JoseBarreto1/projeto-tcc-software/data/_initial.jpeg

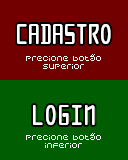
data/_initial.jpeg
