JoseBarreto1/projeto-tcc-software/data/_success.jpeg

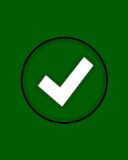
data/_success.jpeg
