JoseBarreto1/projeto-tcc-software/extra/mtmn.png

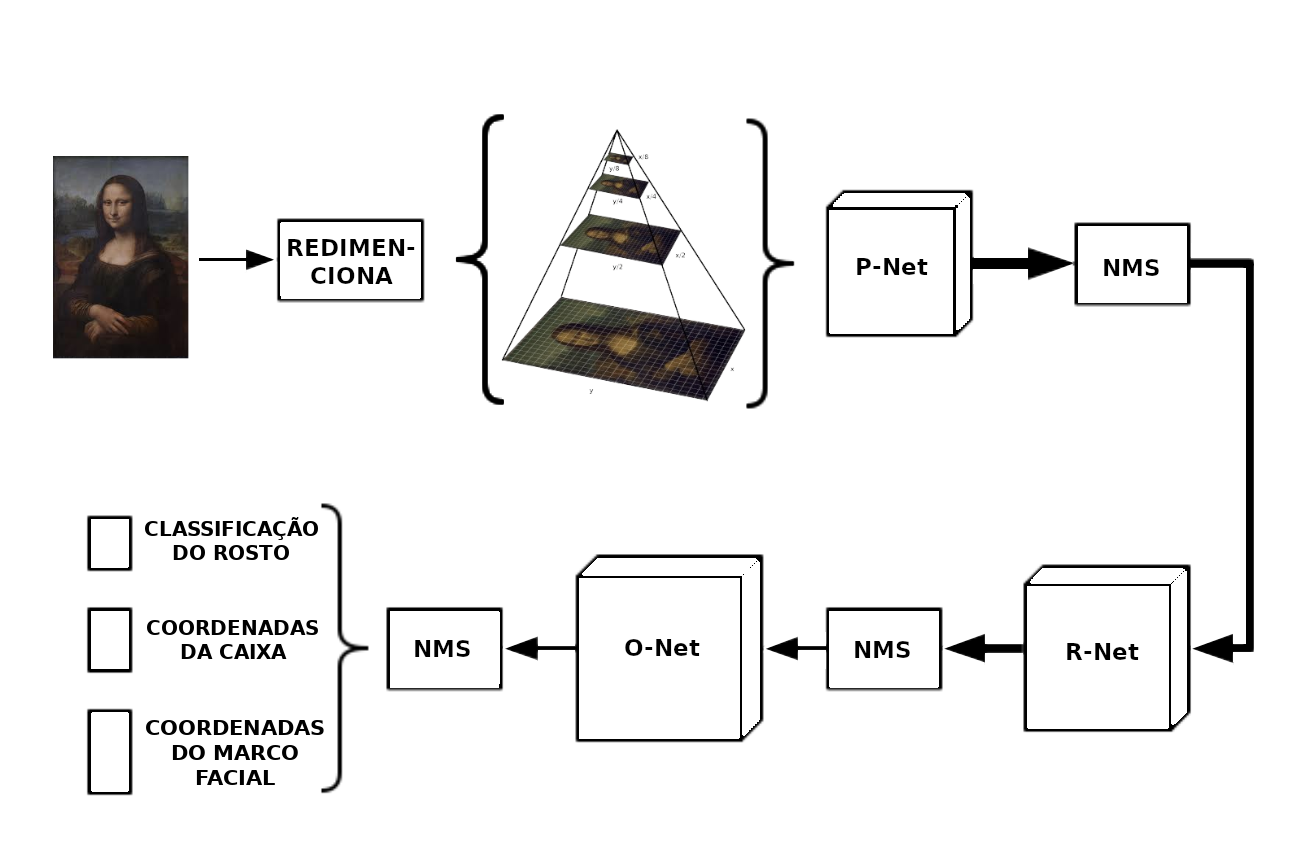
extra/mtmn.png
