JoseBarreto1/projeto-tcc-software/extra/placa_pcb.png

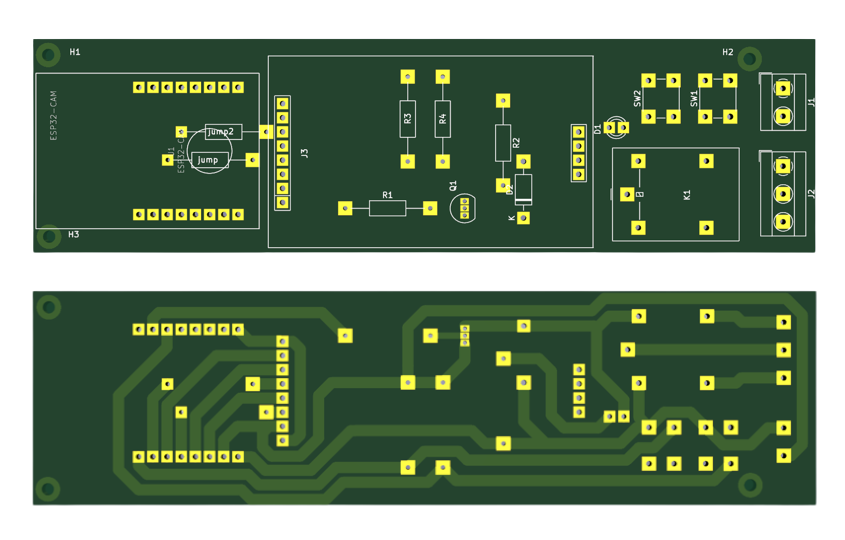
extra/placa_pcb.png
