JoseBarreto1/projeto-tcc-software/data/_failure.jpeg

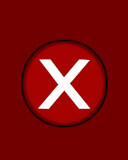
data/_failure.jpeg
