JoseBarreto1/projeto-tcc-software/include/constants.h

// PIN INPUT AND OUTPUT
#define RELAY_PIN     1
#define PUSH_BUTTON_1 3
#define PUSH_BUTTON_2 4
#define FLASH_PIN     4

//MENU
#define MENU_OPTION     0
#define LOGIN_OPTION    1
#define REGISTER_OPTION 2
#define MENU_DEFAULT 	3
#define OPEN_DOOR       4
