JoseBarreto1/projeto-tcc-software/(commit log)

2023-04-29 feat: Inicia implementação do esp32.
2023-09-30 feat: Implementa modulo de reconhecimento facial
2023-10-02 fix: Ajusta implementação do reconhecimento facial. feat: Implementa leitura e escrita dos dados de reconhecimento.
    [main.cpp]
2023-10-09 feat: Implementa metodos de timer, menu, cadastro, login. fix: Ajustes na leitura e armazenamento nos dados do usuario.
    [main.cpp]
2023-10-09 feat: Adiciona novos arquivos para o display tft.
2023-10-09 fix: Ajusta opções do menu inicial, e adiona fluxo de digitar senha antes de cadastrar usuario.
    [main.cpp]
2023-10-14 feat: Organiza o código e Implementa módulos separados de métodos importantes. fix: Realiza ajustes necessários para melhoria e correções do código.
2023-10-15 fix: Corrige splash init. fix: Realiza diversas correções. fix: Atualiza nomes e tipo de dados.
    [camera.cpp, camera.h, constants.h, display.cpp, display.h, face_recognition.h, main.cpp]
2023-10-16 fix: Realiza ajustes e melhorias no código feat: Implementa debug mode
    [camera.cpp, camera.h, constants.h, display.cpp, face_detect.h, face_recognition.h]
2023-10-17 feat: Implementa método para deletar usuario. fix: Atualiza mensagem para iniciar a detecção facial.
    [main.cpp, user.cpp, user.h]
2023-10-17 fix: Corrige extensão do arquivo do usuario.
    [user.cpp]
2023-10-21 fix: Ajustes e melhorias no código fix: Atualiza porta do relay_pin feat: Implementa stop time e init debug
    [constants.h, display.cpp, main.cpp, user.cpp]
2023-10-21 fix: Melhora o método para deletar usuário fix: Atualiza Readme
    [main.cpp, user.cpp, user.h]
2023-10-22 feat: Implementa módulo de salvamento em sd card. fix: Ajusta implementação do deletar usuário.
    [display.cpp, main.cpp, user.cpp, user.h]
2023-10-22 feat: Implementa módulo de salvamento em sd card.
2023-10-22 fix: Corrige fluxo do digitar a senha: Resetar senha temporária e ativa timer assim que entra na tela. fix: Corrige reconhecimento facial, quando o numero maximo de usuários for atingido.
    [main.cpp, user.cpp, user.h]
2023-10-26 fix: Altera posição dos itens na tela, devido inversão dos botões na placa. update: Adiciona arquivos de circuito eletronico desenhado no kicad.
    [display.cpp]
2023-10-26 update: Adiciona arquivos de circuito eletronico desenhado no kicad.
